bondsan-github/Amiga-power-supply/Amiga PSU.JPG

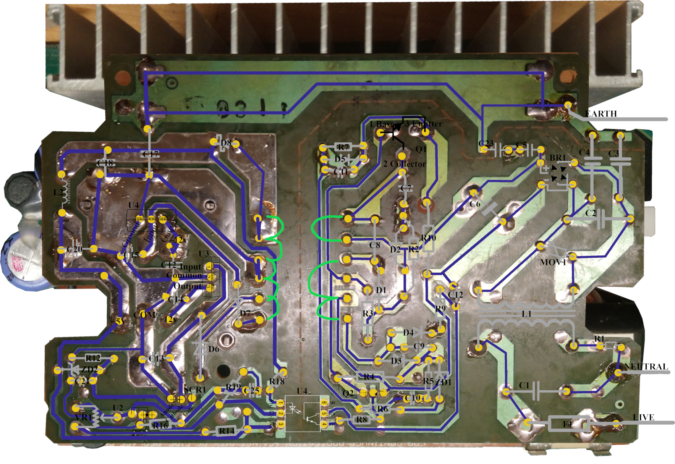
Amiga PSU.JPG
