bondsan-github/Amiga-power-supply/case_bottom.JPG

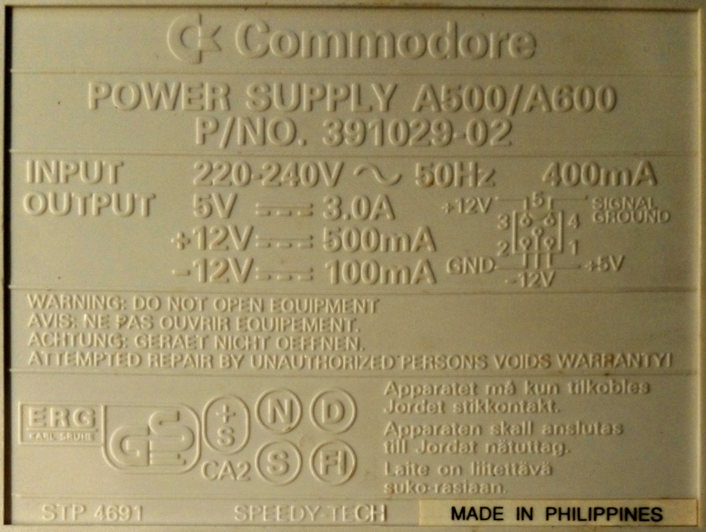
case_bottom.JPG
