bondsan-github/Amiga-power-supply/Bill of materials.ods

Identifier | Type | Sub type | Value | Tolerence | Part number | Function | Manufacturer | Alternative
C1 | Capacitor | radial film | 0.1uF | 250V | KNB1530 | filter
C2 | Capacitor | radial film | 0.1uF | 250V | KNB1530 | filter ( radio-frequency interference ) | Iskra Industrial
C3 | Capacitor | radial film | 3.3nF |  | XE323 0.0033uFM 250V | Noise suppression | OKAYA
C4 | Capacitor | radial film | 3.3nF |  | XE323 0.0033uFM 250V | Noise suppression | OKAYA
C5 | Capacitor | metal film | 2.2nF |  | 565-1Y RS WY 250V 2n2 M
C6 | Capacitor | electrolytic | 68μF | 400V |  |  | TOSIN
C7 | Capacitor | ceramic | 680pF | 10.00% | Y5F 681K 1KV
C8 | Capacitor | ceramic | 10nF |  | Z5U 103M 1KV
C9 | Capacitor | mylar | 220nF |  | 2A224K
C10 | Capacitor | mylar | 10nF |  | 2A103K
C11 | Capacitor | mylar | 100nF | 100V | 104K100V
C12 | Capacitor | mylar | 1nF | 100V | 102K100V
C13 | Capacitor | electrolytic | 1000μF | 25V |  |  | RICHEY
C14 | Capacitor | electrolytic | 100μF | 16V
C15 | Capacitor | electrolytic | 220μF | 25V | Replaced
C16 | Capacitor | electrolytic | 100μF | 16V
C17 | Capacitor | ceramic | 1nF |  | Y5P 102K 2KV
C18 | Capacitor | electrolytic | 2200μF | 10V
C19 | Does not exist | - | - | - | - | - | - | -
C20 | Capacitor | electrolytic | 2200μF | 10V
C21 | Capacitor | ceramic | 100nF | 25V
C22 | Does not exist | - | - | - | - | - | - | -
C23 | Capacitor | metal film | 2.2nF |  | 565-1Y RS WY 250V 2n2 M
C24 | Capacitor | Not populated | 0 | - | - | - | - | -
C25 | Capacitor | electrolytic | 1μF | 50V | 9245 2LM 85°C
MOV1 | Varistor | disc |  |  | VE13M00251K | in-rush / diode rectifier bridge protection | AVX
BR1 | 1 AMP Minature bridge rectifier | DIP 4 |  |  | S1NB 80 18 |  | DIOTEC ELECTRONICS CORP.
R1 | Resistor | disc | 20Ω |  | EUI008 08SP
R2 | Resistor | radial | 470Ω
R3 | Resistor | radial | 270KΩ
R4 | Resistor | radial | 150Ω
R5 | Resistor | radial | 56KΩ | 5.00%
R6 | Resistor | radial | 1KΩ | 5.00%
R7 | Resistor | radial | 1.8KΩ
R8 | Resistor | radial | 120Ω | 5.00%
R9 | Resistor | radial | 10Ω
R10 | Resistor | radial | 2.2KΩ
R11 | Does not exist | - | - | - | - | - | - | -
R12 | Resistor | radial | 68Ω
R13 | Does not exist | - | - | - | - | - | - | -
R14 | Resistor | radial | 820Ω
R15 | Does not exist | - | - | - | - | - | - | -
R16 | Resistor | radial | 1KΩ
R17 | Resistor | Not populated | 0
R18 | Resistor | radial | 33Ω
R19 | Resistor | radial | 3.3KΩ
VR1 | Variable resistor |  | 1KΩ |  | 304M
D1 | Diode | signal | 484
D2 | Diode
D3 | Diode
D4 | Diode
D5 | Diode |  | 449 |  | *40*
D6 | Diode |  | 429 / 5402
D7 | Diode |  | SHORT
D8 | Diode | Schottky barrier rectifier | GI CB..04 924 |  | SB21340 9242 | Guard−ring for stress protection | General Instrument | 1N4935 TO-220AC
ZD1 | Diode | zener | 2.2V
ZD2 | Diode | zener | 6.6V
Q1 | Transistor | NPN Power | 1.5kV, 8A, 125W, TO-3P |  | BU508A
Q2 | Transistor | NPN |  |  | 2N4401 EB250 S
U1 | Octocoupler |  |  |  | CNY75GC
U2 | Precision Programmable Reference |  |  |  | TL431C Ti235BD | shunt regulator
U3 | positive voltage regulator |  | 12V |  | AN7812 M 291 | positive voltage regulator
U4 | negative voltage regulator |  | -12V |  | L7912CV | negative voltage regulator
SCR1 | Thyristor |  | Umax: 200V , Imax: 5.1A , Ug: 1.5V , Ig: 4-15mA , T:125°C |  | S0817BH | circuit breaker | Tag
T1 | Transformer |  |  |  | STP-4691 R1A 0893 |  |  |  | 30339-001-A01 | D-9233 2
L1 | Inductor | mutual / DIP |  |  | ET-28 | filter | Star Park Enterprises | 23126-045 | http://www.tiger-transformer.com/product_display.asp?id=474
L2 | Inductor | Ferrite core
F1 | Fuse | radial | 1A
Wire | Black | Mains | Live
Wire | Blue | Mains | Neutral
Wire | Green + Light Green | Mains | GND
Wire | Thin black | Amiga plug | GND
Wire | Red | Amiga plug | +5V
Wire | Brown | Amiga plug | +12V
Wire | White | Amiga plug | -12V
Wire | Black | Amiga plug | COM
