bondsan-github/Amiga-power-supply/A500_A600_391029_02_v008.PDF

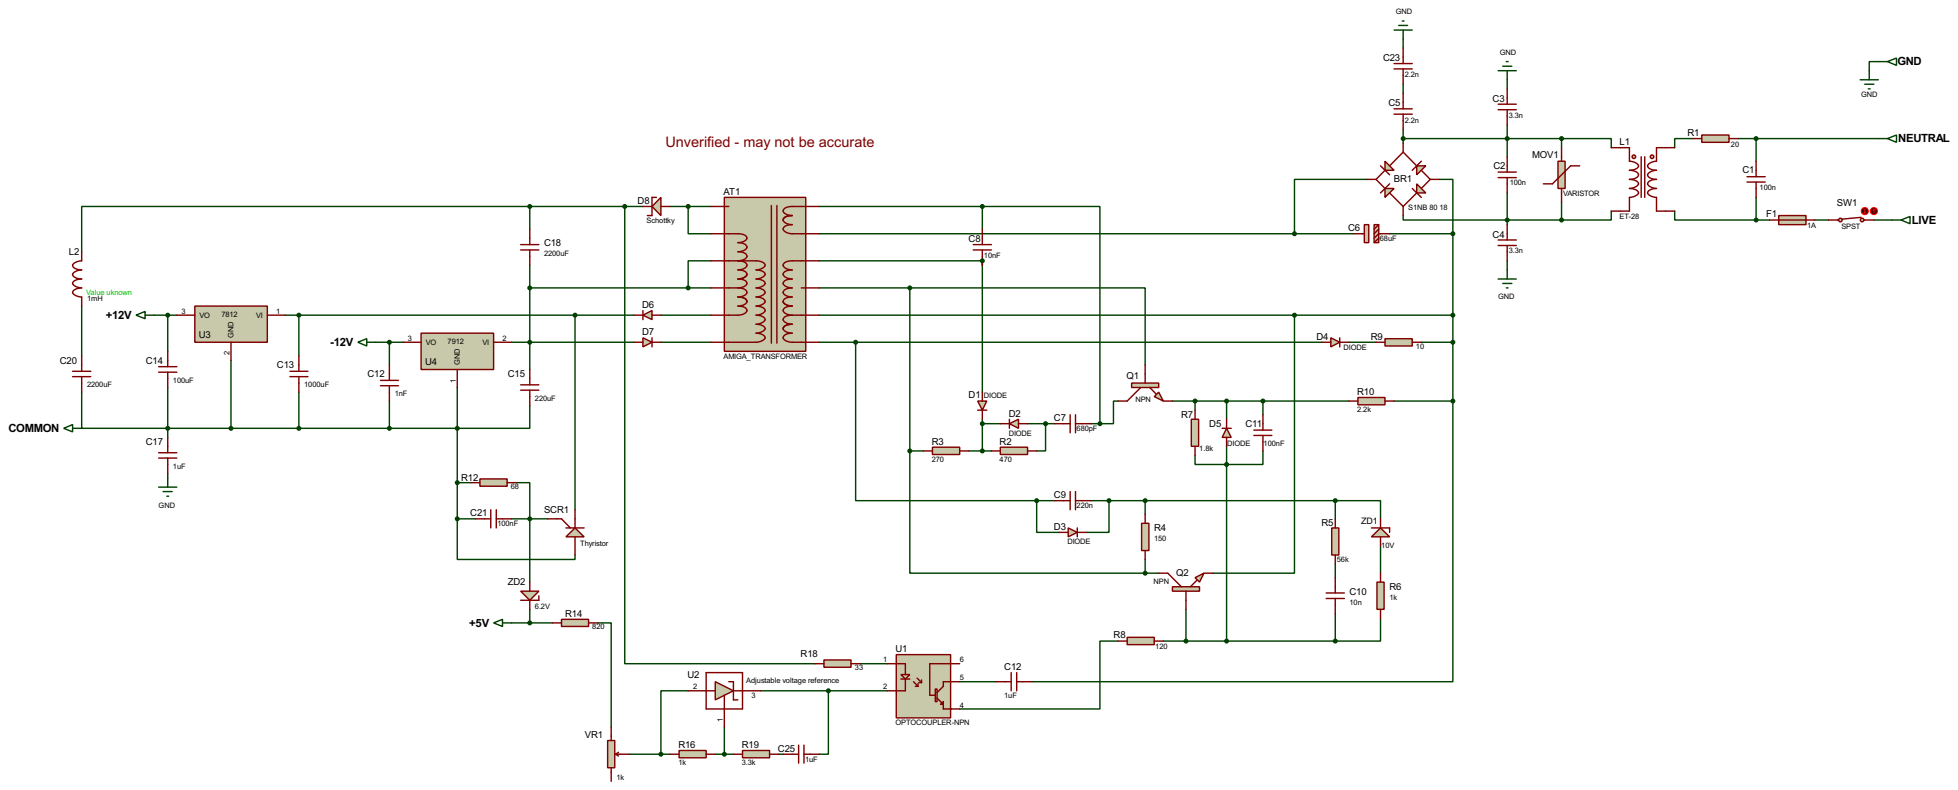
[picture p3: page 1]
