bondsan-github/Amiga-power-supply/(list of files, drawings)

Other design files:
Proteus A500_A600_391029_02.pdsprj
